ArdaNoyanKacar/Headphone_Soundcard/Demo_Picture_Video/Headphone Soundcard Connections.jpg

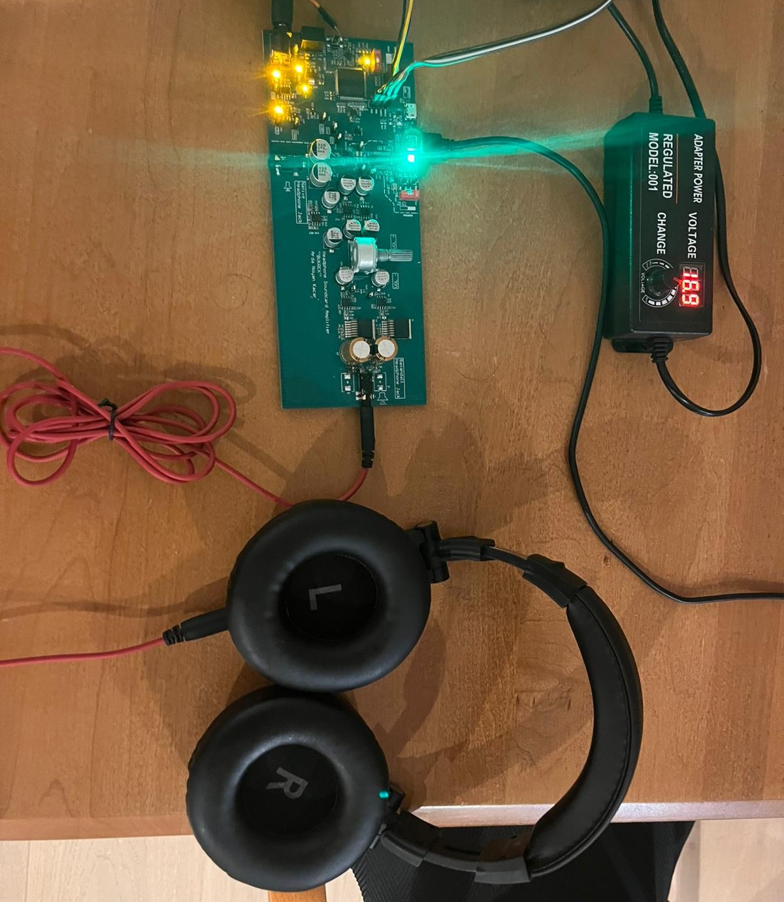
Demo_Picture_Video/Headphone Soundcard Connections.jpg
