ArdaNoyanKacar/Headphone_Soundcard/PCB_Design/Headphone Soundcard 3D.png

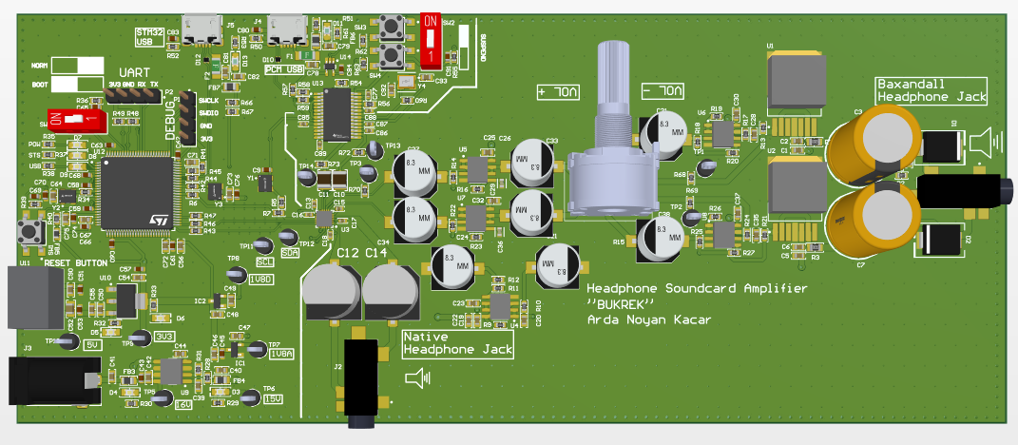
PCB_Design/Headphone Soundcard 3D.png
