ArdaNoyanKacar/Headphone_Soundcard/Core/Src/main.c

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
/* Includes ------------------------------------------------------------------*/
#include "main.h"
#include "usb_device.h"

/* USER CODE BEGIN Includes */
#include "sgtl5000.h"
#include "cmd_ctrl.h"
/* USER CODE END Includes */

I2C_HandleTypeDef hi2c1;

I2S_HandleTypeDef hi2s2;
DMA_HandleTypeDef hdma_spi2_tx;

UART_HandleTypeDef huart2;

void SystemClock_Config(void);
static void MX_GPIO_Init(void);
static void MX_DMA_Init(void);
static void MX_I2C1_Init(void);
static void MX_USART2_UART_Init(void);
static void MX_I2S2_Init(void);
/* USER CODE BEGIN PFP */
int _write(int file, char *ptr, int len)
{
    HAL_UART_Transmit(&huart2, (uint8_t *)ptr, len, HAL_MAX_DELAY);
    return len;
}
/* USER CODE END PFP */

/**
  * @brief  The application entry point.
  * @retval int
  */
int main(void)
{

  /* MCU Configuration--------------------------------------------------------*/

  /* Reset of all peripherals, Initializes the Flash interface and the Systick. */
  HAL_Init();

  /* Configure the system clock */
  SystemClock_Config();

  /* Initialize all configured peripherals */
  MX_GPIO_Init();
  MX_DMA_Init();
  MX_I2C1_Init();
  MX_USB_DEVICE_Init();
  MX_USART2_UART_Init();
  MX_I2S2_Init();
  /* USER CODE BEGIN 2 */
  ctrl_init();
  uint8_t status;
  status = sgtl5000_init();
  if (status != I2C_SUCCESS) {
      printf("SGTL5000 initialization failed\r\n");
  }
  else {
      printf("SGTL5000 initialized successfully\r\n");
  }
  uint16_t reg_value;
  sgtl5000_reg_read(SGTL5000_CHIP_ANA_STATUS, &reg_value);
  printf("SGTL5000 ANA_STATUS: 0x%04X\r\n", reg_value);
  sgtl5000_reg_read(SGTL5000_CHIP_ANA_POWER, &reg_value);
  printf("SGTL5000 ANA_POWER: 0x%04X\r\n", reg_value);
  //sgtl5000_print_all_regs(); // Print all registers for debugging
  /* USER CODE END 2 */

  /* Infinite loop */
  /* USER CODE BEGIN WHILE */
  while (1)
  {
    /* USER CODE END WHILE */

    /* USER CODE BEGIN 3 */
    // Blink LED or do other tasks...
    HAL_GPIO_TogglePin(GPIOE, GPIO_PIN_3);
    ctrl_poll();
  }
  /* USER CODE END 3 */
}

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
