ArdaNoyanKacar/Headphone_Soundcard/Headphone_Soundacard.ioc

Mcu.UserName=STM32F407VGTx
PA11.Signal=USB_OTG_FS_DM
PA12.Signal=USB_OTG_FS_DP
PA13.Signal=SYS_JTMS-SWDIO
PA14.Signal=SYS_JTCK-SWCLK
PA9.Signal=USB_OTG_FS_VBUS
PB10.Signal=I2S2_CK
PB12.Signal=I2S2_WS
PB15.Signal=I2S2_SD
PB6.Signal=I2C1_SCL
PB7.Signal=I2C1_SDA
PC9.Signal=I2S_CKIN
PD5.Signal=USART2_TX
PD6.Signal=USART2_RX
PE3.Signal=GPIO_Output
PE4.Signal=GPIO_Output
PE5.Signal=GPIO_Output
PH0-OSC_IN.Signal=RCC_OSC_IN
PH1-OSC_OUT.Signal=RCC_OSC_OUT
