ArdaNoyanKacar/Headphone_Soundcard/(commit log)

2025-08-10 Initial commit. Clock and GPIO configurations in CubeMX. Started working on SGTL5000 driver
2025-08-11 Fixes to lower level I2C functions because SGTL5000 uses MSB LSB order. Added finished initialization sequence for SGTL5000. Other fixes after initial review
    [sgtl5000.c, sgtl5000.h]
2025-08-17 Testing out the STM32 on the board
2025-09-08 Working LINEIN -> ADC -> DAP -> DAC -> LINEOUT path
